Helno/pellet-grill-controller/Traeger rev 2.3.0.kicad_pro.kicad_pcb

## KiCad design Traeger rev 2.3.0.kicad_pro.kicad_pcb (2026-03-15)

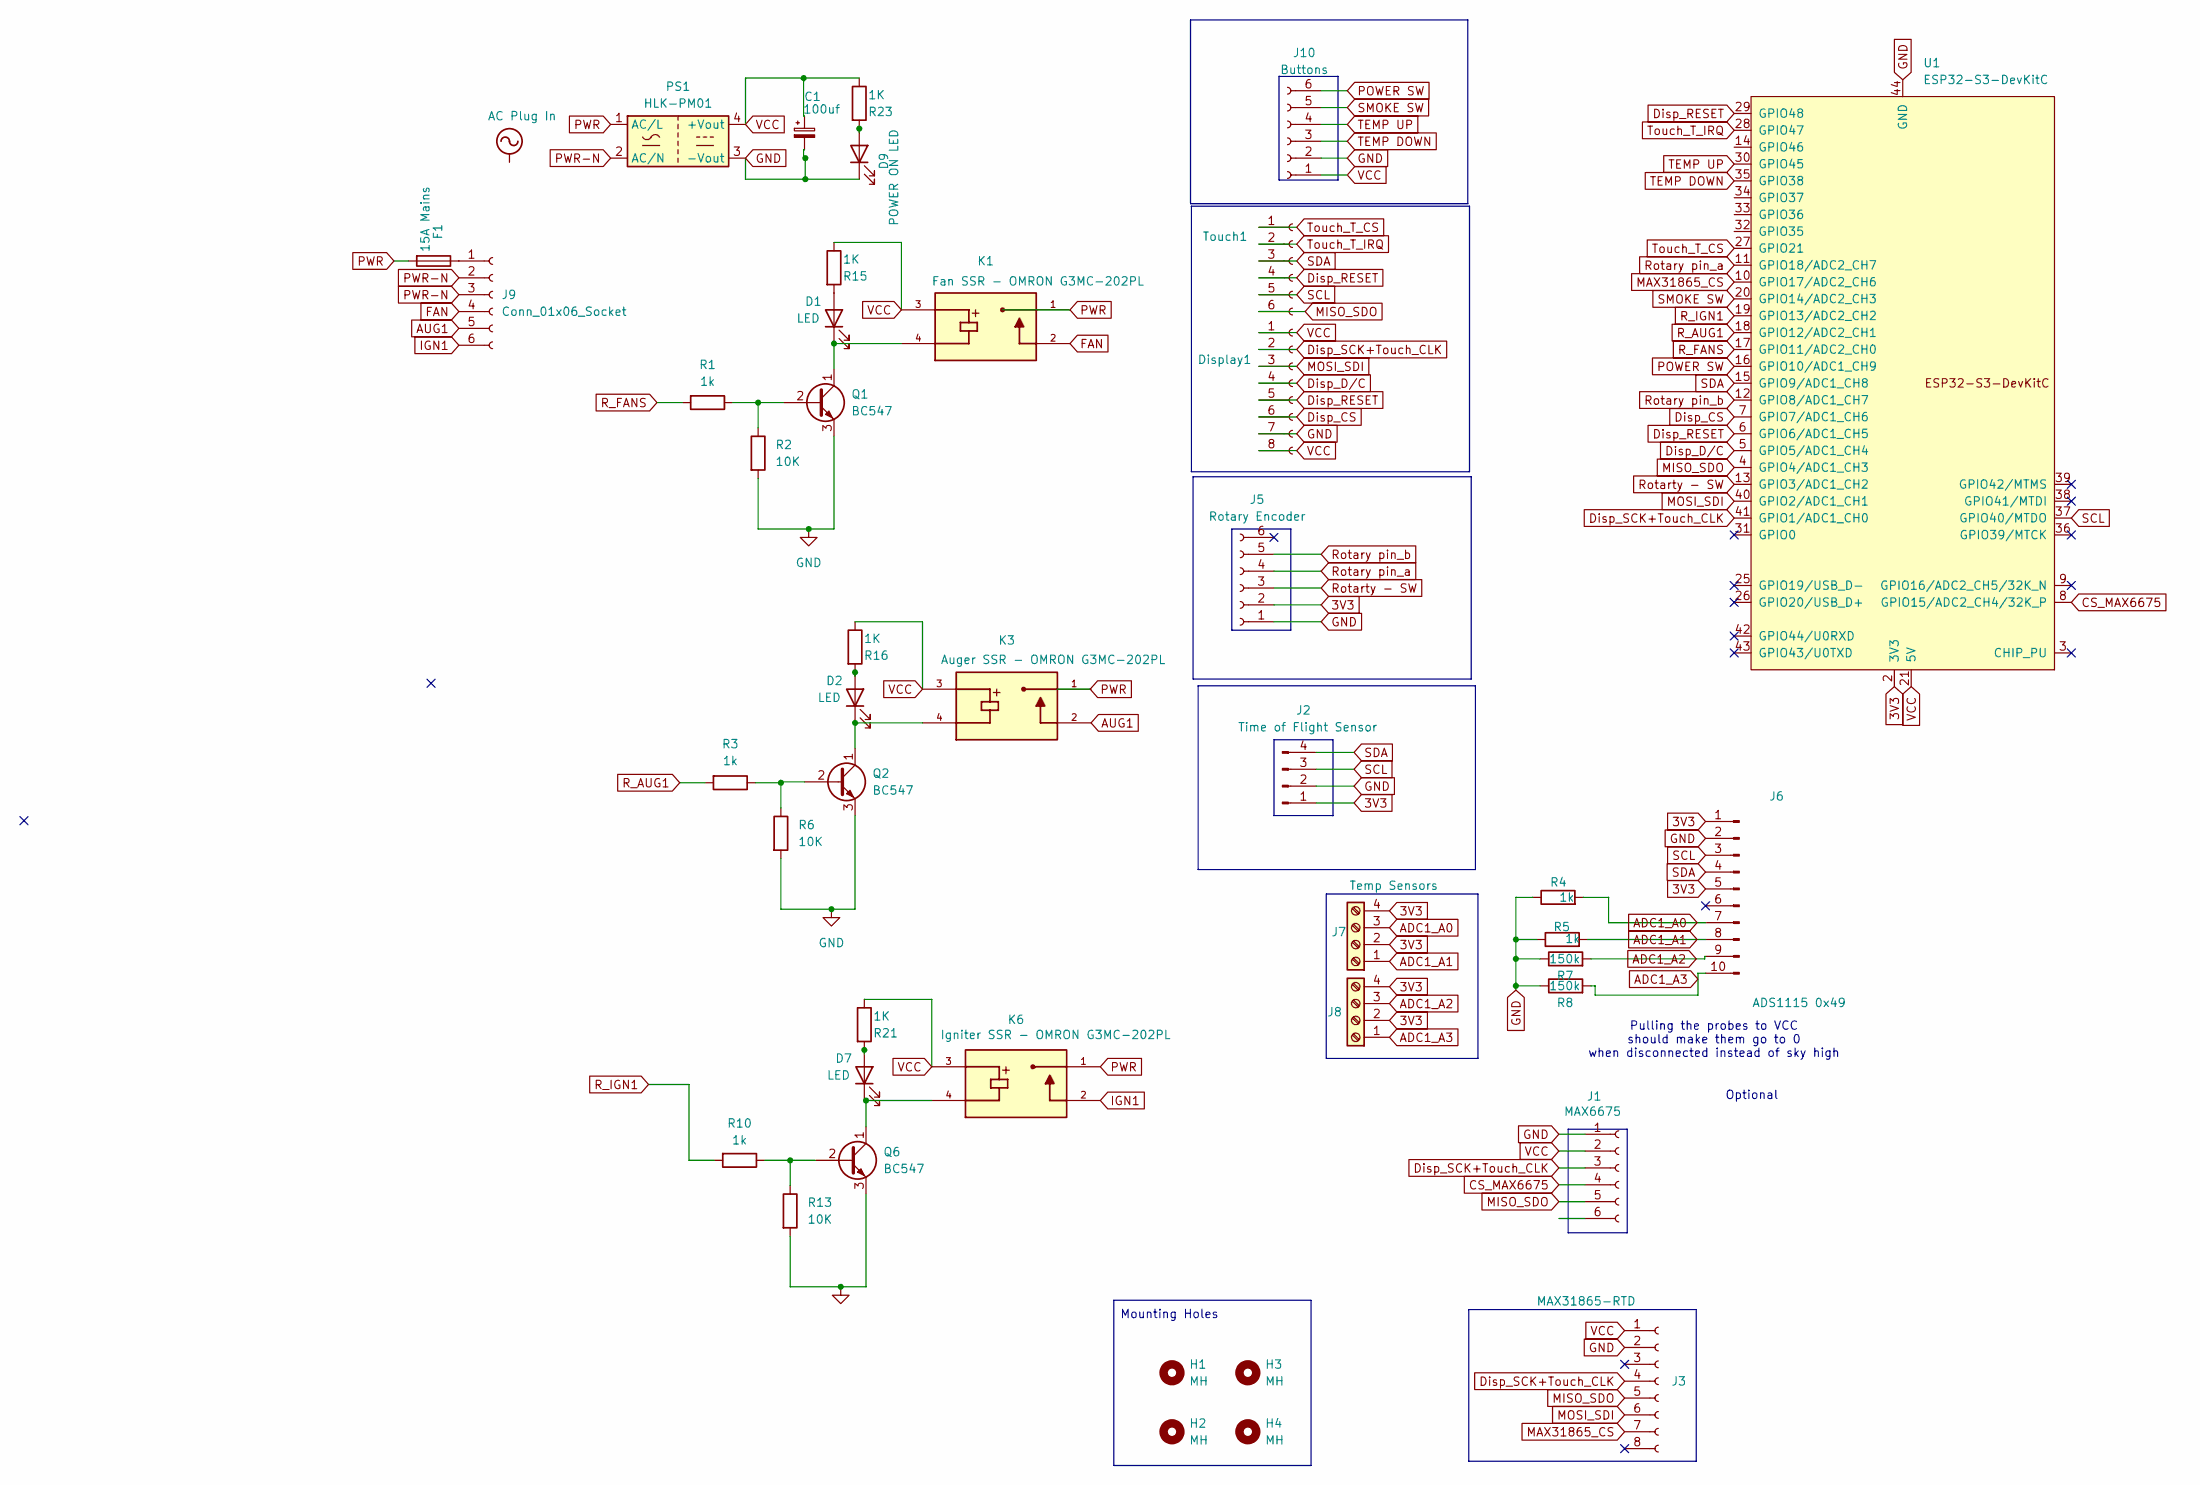
[picture p1: schematic Traeger rev 2.3.0.kicad_pro.kicad_sch, ESP32 Traeger Controller]

Parts:
C1: 100uf; CP_Radial_D8.0mm_P3.50mm
D1, D2, D7: LED; LED_D3.0mm
D9: POWER ON LED; LED_D3.0mm
Display1: Conn_01x08_Socket; JST_EH_B8B-EH-A_1x08_P2.50mm_Vertical
F1: 15A Mains; Fuse Block 3544-2_KEYSTONE
H1, H2, H3, H4: MH; MountingHole_3.2mm_M3
J1: MAX6675; JST_XH_B6B-XH-A_1x06_P2.50mm_Vertical
J2: Time of Flight Sensor; JST_EH_B4B-EH-A_1x04_P2.50mm_Vertical
J3: MAX31865-RTD; PinSocket_1x08_P2.54mm_Vertical
J5: Rotary Encoder; JST_XH_B6B-XH-A_1x06_P2.50mm_Vertical
J6: ADS1115 0x49; PinSocket_1x10_P2.54mm_Vertical
J7, J8: Temp Sensors; TerminalBlock_RND_205-00014_1x04_P5.00mm_Horizontal
J9: Conn_01x06_Socket; TerminalBlock_RND_205-00005_1x06_P5.00mm_Horizontal
J10: Buttons; JST_XH_B6B-XH-A_1x06_P2.50mm_Vertical
K1: Fan SSR - OMRON G3MC-202PL; RELAY_G3MB-202PDC5; PARTREV J091-E1-1A
K3: Auger SSR - OMRON G3MC-202PL; RELAY_G3MB-202PDC5; PARTREV J091-E1-1A
K6: Igniter SSR - OMRON G3MC-202PL; RELAY_G3MB-202PDC5; PARTREV J091-E1-1A
PS1: HLK-PM01; Converter_ACDC_Hi-Link_HLK-PMxx
Q1, Q2, Q6: BC547; TO-92L_Inline
R1, R3, R4, R5, R10: 1k; R_Axial_DIN0207_L6.3mm_D2.5mm_P7.62mm_Horizontal
R2, R6, R13: 10K; R_Axial_DIN0207_L6.3mm_D2.5mm_P7.62mm_Horizontal
R7, R8: 150k; R_Axial_DIN0207_L6.3mm_D2.5mm_P7.62mm_Horizontal
R15, R16, R21, R23: 1K; R_Axial_DIN0207_L6.3mm_D2.5mm_P7.62mm_Horizontal
Touch1: Conn_01x06_Socket; JST_EH_B6B-EH-A_1x06_P2.50mm_Vertical
U1: ESP32-S3-DevKitC

Connections:
3V3: J2.1, J5.2, J6.1, J6.5, J7.2, J7.4, J8.2, J8.4, U1.1 (3V3), U1.2 (3V3)
ADC1_A0: J6.7, J7.3, R4.2
ADC1_A1: J6.8, J7.1, R5.2
ADC1_A2: J6.9, J8.3, R7.2
ADC1_A3: J6.10, J8.1, R8.2
AUG1: J9.5, K3.2
CS_MAX6675: J1.4, U1.8 (GPIO15/ADC2_CH4/32K_P)
Disp_CS: Display1.6, U1.7 (GPIO7/ADC1_CH6)
Disp_D/C: Display1.4, U1.5 (GPIO5/ADC1_CH4)
Disp_RESET: Display1.5, Touch1.4, U1.6 (GPIO6/ADC1_CH5), U1.29 (GPIO48)
Disp_SCK+Touch_CLK: Display1.2, J1.3, J3.4, U1.41 (GPIO1/ADC1_CH0)
FAN: J9.4, K1.2
GND: C1.2, D9.1 (K), Display1.7, J1.1, J2.2, J3.2, J5.1, J6.2, J10.2, PS1.3 (-Vout), Q1.3 (E), Q2.3 (E), Q6.3 (E), R2.2, R4.1, R5.1, R6.2, R7.1, R8.1, R13.2, U1.22 (GND), U1.23 (GND), U1.24 (GND), U1.44 (GND)
IGN1: J9.6, K6.2
MAX31865_CS: J3.7, U1.10 (GPIO17/ADC2_CH6)
MISO_SDO: J1.5, J3.5, Touch1.6, U1.4 (GPIO4/ADC1_CH3)
MOSI_SDI: Display1.3, J3.6, U1.40 (GPIO2/ADC1_CH1)
unnamed: D1.2 (A), R15.2
unnamed: D1.1 (K), K1.4, Q1.1 (C)
unnamed: D2.2 (A), R16.2
unnamed: D2.1 (K), K3.4, Q2.1 (C)
unnamed: D7.2 (A), R21.2
unnamed: D7.1 (K), K6.4, Q6.1 (C)
unnamed: D9.2 (A), R23.2
unnamed: F1.1, J9.1
unnamed: Q1.2 (B), R1.1, R2.1
unnamed: Q2.2 (B), R3.1, R6.1
unnamed: Q6.2 (B), R10.1, R13.1
POWER SW: J10.6, U1.16 (GPIO10/ADC1_CH9)
PWR: F1.2, K1.1, K3.1, K6.1, PS1.1 (AC/L)
PWR-N: J9.2, J9.3, PS1.2 (AC/N)
R_AUG1: R3.2, U1.18 (GPIO12/ADC2_CH1)
R_FANS: R1.2, U1.17 (GPIO11/ADC2_CH0)
R_IGN1: R10.2, U1.19 (GPIO13/ADC2_CH2)
Rotarty - SW: J5.3, U1.13 (GPIO3/ADC1_CH2)
Rotary pin_a: J5.4, U1.11 (GPIO18/ADC2_CH7)
Rotary pin_b: J5.5, U1.12 (GPIO8/ADC1_CH7)
SCL: J2.3, J6.3, Touch1.5, U1.37 (GPIO40/MTDO)
SDA: J2.4, J6.4, Touch1.3, U1.15 (GPIO9/ADC1_CH8)
SMOKE SW: J10.5, U1.20 (GPIO14/ADC2_CH3)
TEMP DOWN: J10.3, U1.35 (GPIO38)
TEMP UP: J10.4, U1.30 (GPIO45)
Touch_T_CS: Touch1.1, U1.27 (GPIO21)
Touch_T_IRQ: Touch1.2, U1.28 (GPIO47)
VCC: C1.1, Display1.1, Display1.8, J1.2, J3.1, J10.1, K1.3, K3.3, K6.3, PS1.4 (+Vout), R15.1, R16.1, R21.1, R23.1, U1.21 (5V)

Notes on the sheet:
Pulling the probes to VCC should make them go to 0 when disconnected instead of sky high
Optional
Mounting Holes

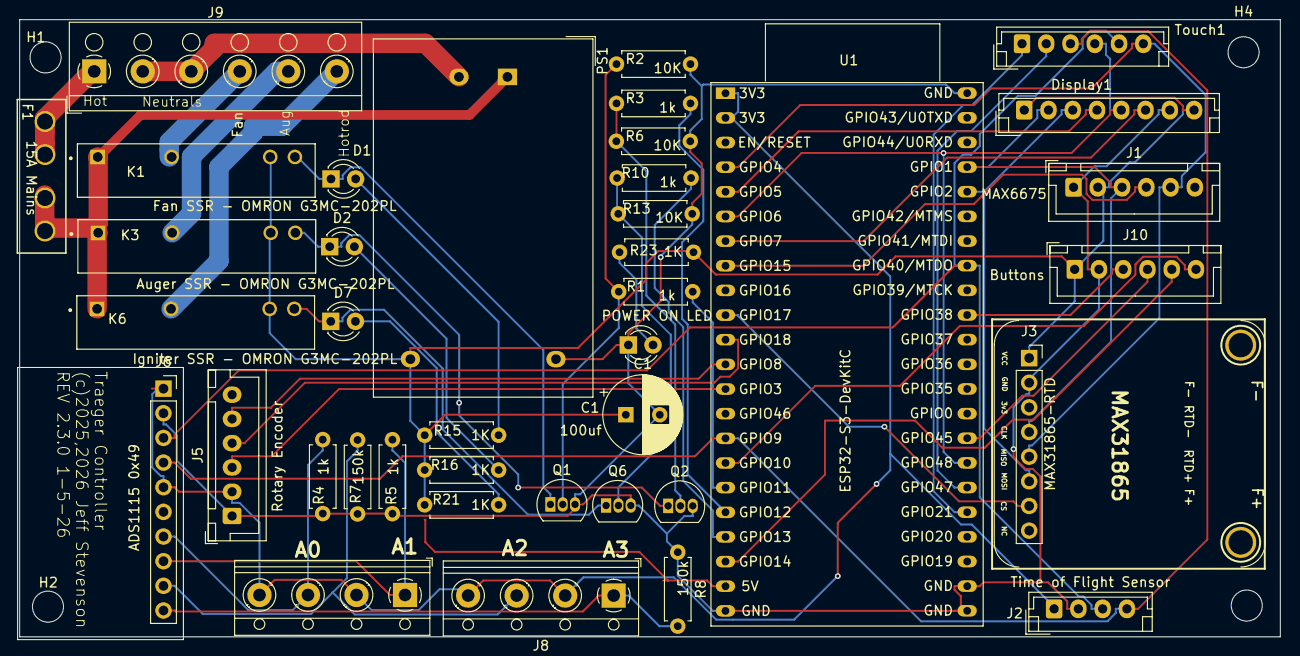
[picture p2: board Traeger rev 2.3.0.kicad_pro.kicad_pcb from above]

Board: 2 copper layers, 129.9 x 63.6 mm, 45 parts (0 on the bottom side), 45 nets.

Other parts of the board:
U$18, U$19: MOUNTINGHOLE2.5; MOUNTINGHOLE_2.5_PLATED
