Helno/pellet-grill-controller/pellet-grill-controller.yaml

# updated 8/15/25
# added flame-out relighting w/ max6675 sensor
# PID values that work really well:
# Pb=60 Ti=180 Td=45
# theta=12 tau=300 
# center= 0.0 stable win=8

esphome:
  name: "pellet-grill-controller"
  friendly_name: Pellet Grill Controller
  platformio_options:
    board_build.flash_mode: dio 
  on_boot:
    priority: -100
    then:
      - lambda: id(status_msg).publish_state("Ready");
      - delay: 3s
      - lambda: id(mydisplay).update();
      - switch.turn_on: backlight

      # Check RTD temperature and turn on fans if needed
      - if:
          condition:
            lambda: return id(rtd_temperature_f).state > 175.0;
          then:
            - switch.turn_on: fans_on_off_sw
            - lambda: id(status_msg).publish_state("Hot startup - Fans ON");
            - script.execute: sc_shutdown
          else:
            - switch.turn_off: fans_on_off_sw
            - lambda: id(status_msg).publish_state("Ready!");
      #- script.execute: sc_monitor_temp_for_fans
packages:
touchscreen:
  - platform: ft63x6
    i2c_id: i2c_bus
    interrupt_pin: GPIO47
    reset_pin: GPIO48
    id: my_touchscreen
    #update_interval: 25ms
    calibration:
      x_min: 26
      x_max: 308
      y_min: 25
      y_max: 443
    transform:
      mirror_x: true
      mirror_y: true
      swap_xy: false
    on_touch:
      - lambda: |-
            ESP_LOGI("calibration", "x=%d, y=%d, x_raw=%d, y_raw=%0d",
                touch.x,
                touch.y,
                touch.x_raw,
                touch.y_raw
                );
  
psram:
  mode: octal
  speed: 80MHz
esp32:
  board: esp32-s3-devkitc-1
  variant: esp32s3
  flash_size: 16MB
  framework:
    type: esp-idf
    version: recommended
    sdkconfig_options:
      CONFIG_ESP32_S3_BOX_BOARD: "y"
      CONFIG_ESP_WIFI_ENABLE_WPA3_SAE: "y"

api:
  reboot_timeout: 24h
logger:
    level: DEBUG
    logs:
      component: none   # screen spam updates suppressed
      api.connection: ERROR
      max31865: none
      max6675: none
      ads1115.sensor: ERROR
      sensor: ERROR 
      number: ERROR
      ili9xxx: ERROR
      FT63X6: ERROR
      spi: ERROR
      touchscreen: ERROR
      I2C: ERROR

ota:
  - platform: esphome
wifi:
  use_address: 10.59.233.56
  ssid: !secret wifi_ssid
  password: !secret wifi_password
  power_save_mode: none
  ap:
    ssid: "Pellet-Grill-Fallback"
    password: !secret wifi_password
captive_portal:

web_server:    #you can remove this if you dont want to access the web server from your network

#need to wire up touchscreen and add a CS pin to the display

spi:
  - id: spi_bus
    clk_pin: GPIO1 #display SCK/touch T_CLK
    mosi_pin: GPIO2 #SDI-max / display /touch T_DIN
    miso_pin: GPIO4 #SDO-max / touch T_DO, display doesnt need MISO

display:
  - platform: ili9xxx
    id: mydisplay
    setup_priority: -500
    spi_id: spi_bus
    data_rate: 40MHz
    model: ILI9488_A #TFT 3.5  
    dc_pin: GPIO5    
    cs_pin: GPIO7 
    reset_pin: GPIO6 #pin 5 display
    color_palette: 8BIT
    #LED - GPIO16 via jumper, controlled by backlight switch
    rotation: 90
    update_interval: 0.5s
    invert_colors: true
    show_test_card: false
    lambda: |-
       auto black = Color(0, 0, 0);
       auto red = Color(255, 0, 0);
       auto green = Color(0, 255, 0);
       auto blue = Color(0, 0, 255);
       auto white = Color(255, 255, 255);    
       auto grey = Color(120, 120, 120);

       // Temperature conversion helper: F->display unit
       auto to_disp = [](float f) -> float { return id(use_celsius) ? (f - 32.0f) * 5.0f / 9.0f : f; };
       auto unit_str = id(use_celsius) ? "C" : "F";

       //Status msg
        it.filled_rectangle(0, 452, 320, 28, Color(80, 80, 80)); // Grey background with padding
        it.print(1, 454, id(font20), id(status_msg).state.c_str());
        it.printf(306, 454, id(font20), white, TextAlign::TOP_RIGHT, "°%s", unit_str);

        it.printf(77, 1, id(font30), white, TextAlign::TOP_CENTER, "Heat");
        it.printf(243, 1, id(font30), white, TextAlign::TOP_CENTER, "Smoke");
       // Power button
       if (id(go).state && !id(smoke_mode).state) {
         // Active state - bright green with 3D effect
         it.filled_rectangle(56, 42, 42, 58, Color(0, 200, 0));  // Main button
         it.filled_rectangle(56, 40, 42, 3, Color(0, 255, 0));   // Highlight
         it.filled_rectangle(56, 100, 42, 3, Color(0, 100, 0));  // Shadow
         it.filled_rectangle(53, 42, 3, 58, Color(0, 255, 0));   // Left highlight
         it.filled_rectangle(98, 42, 3, 58, Color(0, 100, 0));   // Right shadow
       } else {
         // Inactive state - dark gray with 3D effect
         it.filled_rectangle(56, 42, 42, 58, Color(80, 80, 80)); // Main button
         it.filled_rectangle(56, 40, 42, 3, Color(120, 120, 120)); // Highlight
         it.filled_rectangle(56, 100, 42, 3, Color(40, 40, 40));   // Shadow
         it.filled_rectangle(53, 42, 3, 58, Color(120, 120, 120)); // Left highlight
         it.filled_rectangle(98, 42, 3, 58, Color(40, 40, 40));    // Right shadow
       }
       // Smoke button
       if (id(smoke_mode).state) {
         // Active state - bright blue with 3D effect
         it.filled_rectangle(222, 42, 42, 58, Color(0, 0, 200));  // Main button
         it.filled_rectangle(222, 40, 42, 3, Color(0, 0, 255));   // Highlight
         it.filled_rectangle(222, 100, 42, 3, Color(0, 0, 100));  // Shadow
         it.filled_rectangle(219, 42, 3, 58, Color(0, 0, 255));   // Left highlight
         it.filled_rectangle(264, 42, 3, 58, Color(0, 0, 100));   // Right shadow
       } else {
         // Inactive state - dark gray with 3D effect
         it.filled_rectangle(222, 42, 42, 58, Color(80, 80, 80)); // Main button
         it.filled_rectangle(222, 40, 42, 3, Color(120, 120, 120)); // Highlight
         it.filled_rectangle(222, 100, 42, 3, Color(40, 40, 40));   // Shadow
         it.filled_rectangle(219, 42, 3, 58, Color(120, 120, 120)); // Left highlight
         it.filled_rectangle(264, 42, 3, 58, Color(40, 40, 40));    // Right shadow
       }
       if (id(knob_mode) == 1) {
         it.printf(77, 118, id(font20), Color(0, 220, 0), TextAlign::TOP_CENTER, "Probe Set");
         it.printf(77, 140, id(font45), Color(0, 220, 0), TextAlign::TOP_CENTER, "%.0f°", to_disp(id(meat_probe_setpoint).state));
       } else if (id(smoke_mode).state) {
         it.printf(77, 118, id(font20), white, TextAlign::TOP_CENTER, "%s", id(p_select).current_option().c_str());
         // Slow flash: visible for ~700ms, hidden for ~300ms
         bool blink_on = (millis() % 1000) < 700;
         bool auger_on = id(auger_1_sw).state;
         auto on_color = (auger_on && blink_on) ? Color(255, 165, 0) : grey;
         auto off_color = (!auger_on && blink_on) ? white : grey;
         it.printf(37, 142, id(font30), on_color, TextAlign::TOP_CENTER, "%.0fs", id(smoke_on_time).state);
         it.printf(77, 142, id(font30), grey, TextAlign::TOP_CENTER, "/");
         it.printf(117, 142, id(font30), off_color, TextAlign::TOP_CENTER, "%.0fs", id(smoke_off_time).state);
       } else {
         it.printf(77, 118, id(font20), white, TextAlign::TOP_CENTER, "Set Temp");
         it.printf(77, 140, id(font45), white, TextAlign::TOP_CENTER, "%.0f°", to_disp(id(smoker_set_temp).state));
       }

       it.printf(243, 118, id(font20), red, TextAlign::TOP_CENTER, "RTD Temp");
       it.printf(289, 140, id(font45), red, TextAlign::TOP_RIGHT, "%.0f°", to_disp(id(rtd_temperature_f).state));

        // Temperature graph (y=200 to y=283, full width)
        {
          const int gx = 0;       // left edge
          const int gy = 200;     // top of graph
          const int gw = 320;     // width
          const int gh = 83;      // height
          const float y_min = id(use_celsius) ? 65.0f : 150.0f;
          float y_max = id(graph_y_max);
          float y_range = y_max - y_min;

          // Background
          it.filled_rectangle(gx, gy, gw, gh, Color(20, 20, 20));

          // Horizontal gridlines
          auto gridlines = id(smoke_mode).state
            ? (id(use_celsius) ? std::vector<int>{80, 95, 110} : std::vector<int>{175, 200, 225})
            : (id(use_celsius) ? std::vector<int>{100, 150, 200} : std::vector<int>{200, 300, 400});
          for (int grid_f : gridlines) {
            if (grid_f > y_min && grid_f < y_max) {
              int grid_y = gy + gh - (int)((grid_f - y_min) / y_range * gh);
              it.horizontal_line(gx, grid_y, gw, Color(50, 50, 50));
              it.printf(gx + 2, grid_y - 9, id(font_tiny), Color(100, 100, 100), "%d", grid_f);
            }
          }

          // Plot lines
          int n = id(graph_set_temp).size();
          if (n > 1) {
            for (int i = 1; i < n; i++) {
              // X positions - spread across full width
              int x1 = (i-1) * 2;
              int x2 = i * 2;

              // Set temp - white
              float sv1 = std::max(y_min, std::min(y_max, id(graph_set_temp)[i-1]));
              float sv2 = std::max(y_min, std::min(y_max, id(graph_set_temp)[i]));
              int sy1 = gy + gh - (int)((sv1 - y_min) / y_range * gh);
              int sy2 = gy + gh - (int)((sv2 - y_min) / y_range * gh);
              it.line(x1, sy1, x2, sy2, white);

              // RTD temp - red
              float rv1 = std::max(y_min, std::min(y_max, id(graph_rtd_temp)[i-1]));
              float rv2 = std::max(y_min, std::min(y_max, id(graph_rtd_temp)[i]));
              int ry1 = gy + gh - (int)((rv1 - y_min) / y_range * gh);
              int ry2 = gy + gh - (int)((rv2 - y_min) / y_range * gh);
              it.line(x1, ry1, x2, ry2, red);

              // Probe 1 - green (only when connected)
              if ((int)id(graph_probe1_temp).size() > i) {
                float p1v1 = id(graph_probe1_temp)[i-1];
                float p1v2 = id(graph_probe1_temp)[i];
                if (!isnan(p1v1) && !isnan(p1v2)) {
                  p1v1 = std::max(y_min, std::min(y_max, p1v1));
                  p1v2 = std::max(y_min, std::min(y_max, p1v2));
                  int p1y1 = gy + gh - (int)((p1v1 - y_min) / y_range * gh);
                  int p1y2 = gy + gh - (int)((p1v2 - y_min) / y_range * gh);
                  it.line(x1, p1y1, x2, p1y2, Color(0, 220, 0));
                }
              }

              // Probe 2 - yellow (only when connected)
              if ((int)id(graph_probe2_temp).size() > i) {
                float p2v1 = id(graph_probe2_temp)[i-1];
                float p2v2 = id(graph_probe2_temp)[i];
                if (!isnan(p2v1) && !isnan(p2v2)) {
                  p2v1 = std::max(y_min, std::min(y_max, p2v1));
                  p2v2 = std::max(y_min, std::min(y_max, p2v2));
                  int p2y1 = gy + gh - (int)((p2v1 - y_min) / y_range * gh);
                  int p2y2 = gy + gh - (int)((p2v2 - y_min) / y_range * gh);
                  it.line(x1, p2y1, x2, p2y2, Color(255, 200, 0));
                }
              }
            }
          }

          // Meat probe setpoint line (dashed green, only if probe connected)
          bool any_probe = id(a0_voltage).state > 0.2f || id(a1_voltage).state > 0.2f;
          if (any_probe) {
            float probe_set_disp = to_disp(id(meat_probe_setpoint).state);
            if (probe_set_disp > y_min && probe_set_disp < y_max) {
              int psy = gy + gh - (int)((probe_set_disp - y_min) / y_range * gh);
              // Dashed line
              for (int dx = gx; dx < gx + gw; dx += 6) {
                it.horizontal_line(dx, psy, 3, Color(0, 220, 0));
              }
              it.printf(gx + gw - 2, psy - 9, id(font_tiny), Color(0, 220, 0), TextAlign::TOP_RIGHT, "%.0f", probe_set_disp);
            }
          }

          // Border
          it.rectangle(gx, gy, gw, gh, Color(80, 80, 80));
        }

        // Y offset for positioning
        int y_offset = 294;

        // Draw main body of BBQ trailer
        it.rectangle(0, y_offset-8, 320, 158, blue);

        // Animation angle - used by fan and auger
        float angle = fmod(millis() / 50.0, 360.0) * M_PI / 180.0;

        // FAN - curved blade fan at cx=190
        {
          int cx = 190;
          int cy = y_offset + 24;
          int fan_r = 21;
          it.circle(cx, cy, fan_r, white); // housing circle
          if (id(fans_on_off_sw).state) {
            // 4 curved blades
            for (int i = 0; i < 4; i++) {
              float base_angle = angle + (i * M_PI / 2);
              // Each blade: arc from base to base+70deg with radius sweep
              for (int step = 0; step < 8; step++) {
                float a1 = base_angle + step * (M_PI/2 * 0.7f / 8.0f);
                float a2 = base_angle + (step+1) * (M_PI/2 * 0.7f / 8.0f);
                float r1 = fan_r * 0.2f + step * (fan_r * 0.8f / 8.0f);
                float r2 = fan_r * 0.2f + (step+1) * (fan_r * 0.8f / 8.0f);
                it.line(
                  cx + (int)(r1 * cos(a1)), cy + (int)(r1 * sin(a1)),
                  cx + (int)(r2 * cos(a2)), cy + (int)(r2 * sin(a2)),
                  green
                );
              }
            }
          } else {
            // Static - just spokes
            for (int i = 0; i < 4; i++) {
              float a = i * M_PI / 2;
              it.line(cx, cy, cx + (int)(fan_r * cos(a)), cy + (int)(fan_r * sin(a)), green);
            }
          }
          it.filled_circle(cx, cy, 4, green);
        }

        // HOTROD
        {
          int cx = 190;
          if (id(hotrod_1_sw).state) {
            it.rectangle(cx-21, y_offset + 73, 42, 68, white);
            it.filled_rectangle(cx-21, y_offset + 73, 42, 16, Color(255,0,0));
          } else {
            it.rectangle(cx-21, y_offset + 73, 42, 68, white);
          }
          // Burn pot temperature centered inside hotrod box
          it.printf(cx-16, y_offset + 101, id(font20), Color(255, 100, 0), "%.0f°",
            id(use_celsius) ? id(firepot_temperature).state : id(firepot_temperature).state * 1.8f + 32.0f);
        }

        // AUGER - horizontal side view screw feeding from hopper base to hotrod
        // Runs from x=148 to x=263, centered at y=430
        {
          const int al = 211;   // left x (hotrod right edge cx+21)
          const int ar2 = 285;  // right x (hopper base right corner)
          const int ay = y_offset + 129; // bottom edge aligned with hopper bottom
          const int aw = 10;    // half-height of screw thread
          const int shaft = 2;  // half-height of shaft
          Color auger_col = id(auger_1_sw).state ? Color(255, 165, 0) : Color(100, 100, 100);

          // Tube outline
          it.line(al, ay - aw - 2, ar2, ay - aw - 2, white);
          it.line(al, ay + aw + 2, ar2, ay + aw + 2, white);

          // Shaft (horizontal center line)
          it.filled_rectangle(al, ay - shaft, ar2 - al, shaft*2, auger_col);

          // Helix wrapping around horizontal shaft
          float phase = id(auger_1_sw).state ? fmod(millis() / 150.0f, 2.0f * M_PI) : 0.0f;
          int num_coils = 6;
          int steps = 80;

          // Back helix first (dimmer)
          for (int s = 0; s < steps; s++) {
            float t1 = (float)s / steps;
            float t2 = (float)(s+1) / steps;
            float x1f = al + t1 * (ar2 - al);
            float x2f = al + t2 * (ar2 - al);
            float a1 = phase + t1 * num_coils * 2.0f * M_PI;
            float a2 = phase + t2 * num_coils * 2.0f * M_PI;
            float by1 = ay + aw * sin(a1 + M_PI);
            float by2 = ay + aw * sin(a2 + M_PI);
            if (sin(a1) < 0) {
              it.line((int)x1f, (int)by1, (int)x2f, (int)by2, Color(80, 60, 0));
            }
          }
          // Front helix on top
          for (int s = 0; s < steps; s++) {
            float t1 = (float)s / steps;
            float t2 = (float)(s+1) / steps;
            float x1f = al + t1 * (ar2 - al);
            float x2f = al + t2 * (ar2 - al);
            float a1 = phase + t1 * num_coils * 2.0f * M_PI;
            float a2 = phase + t2 * num_coils * 2.0f * M_PI;
            float fy1 = ay + aw * sin(a1);
            float fy2 = ay + aw * sin(a2);
            if (sin(a1) >= 0) {
              it.line((int)x1f, (int)fy1, (int)x2f, (int)fy2, auger_col);
            }
          }
        }

          // Probe temps (bottom-left of BBQ body)
          it.filled_rectangle(1, 294, 128, 149, black);
          bool p1_conn = id(a0_voltage).state > 0.2f;
          bool p2_conn = id(a1_voltage).state > 0.2f;
          float probe_target = id(meat_probe_setpoint).state;
          bool probe_blink = (millis() % 800) < 500;
          if (p1_conn && p2_conn) {
            // Two probes - stacked compact layout
            bool p1_done = id(a0_temperature).state >= probe_target;
            bool p2_done = id(a1_temperature).state >= probe_target;
            auto p1_col = (p1_done && probe_blink) ? black : Color(0, 220, 0);
            auto p2_col = (p2_done && probe_blink) ? black : Color(255, 200, 0);
            it.printf(65, 304, id(font20), p1_col, TextAlign::TOP_CENTER, "P1");
            it.printf(65, 326, id(font40), p1_col, TextAlign::TOP_CENTER, "%.0f°", to_disp(id(a0_temperature).state));
            it.printf(65, 378, id(font20), p2_col, TextAlign::TOP_CENTER, "P2");
            it.printf(65, 400, id(font40), p2_col, TextAlign::TOP_CENTER, "%.0f°", to_disp(id(a1_temperature).state));
          } else if (p1_conn) {
            // Single probe - large centered
            bool p1_done = id(a0_temperature).state >= probe_target;
            auto p1_col = (p1_done && probe_blink) ? black : Color(0, 220, 0);
            it.printf(65, 330, id(font20), p1_col, TextAlign::TOP_CENTER, "P1");
            it.printf(65, 354, id(font45), p1_col, TextAlign::TOP_CENTER, "%.0f°", to_disp(id(a0_temperature).state));
          } else if (p2_conn) {
            // Single probe - large centered
            bool p2_done = id(a1_temperature).state >= probe_target;
            auto p2_col = (p2_done && probe_blink) ? black : Color(255, 200, 0);
            it.printf(65, 330, id(font20), p2_col, TextAlign::TOP_CENTER, "P2");
            it.printf(65, 354, id(font45), p2_col, TextAlign::TOP_CENTER, "%.0f°", to_disp(id(a1_temperature).state));
          }

          // Pellet hopper graphic - shifted left
          {
            const int hx = 245;     // left edge (right side)
            const int hy = 295;     // top (just inside BBQ body)
            const int hw = 60;      // full width
            const int htotal = 140; // total height
            const int hmid = hy + htotal/2;
            const int hbot = hy + htotal;
            const int hw3 = hw / 3;
            const int hbx = hx + (hw - hw3) / 2;

            float dist = id(pellet_level).state;
            if (isnan(dist) || dist < 0.047f) dist = 0.047f;
            if (dist > 0.36f) dist = 0.36f;
            float pct = 1.0f - ((dist - 0.047f) / (0.36f - 0.047f));
            int fill_pct = (int)(pct * 100);
            float fill_h = pct * (float)htotal;
            int fill_top = hbot - (int)fill_h;

            // Draw fill (red) scanline by scanline clipped to hopper shape
            for (int fy = (fill_top < hy ? hy : fill_top); fy < hbot; fy++) {
              int left_edge, right_edge;
              if (fy < hmid) {
                left_edge = hx;
                right_edge = hx + hw;
              } else {
                float t = (float)(fy - hmid) / (float)(hbot - hmid);
                left_edge  = hx  + (int)(t * (hbx - hx));
                right_edge = hx + hw - (int)(t * (hbx - hx));
              }
              it.horizontal_line(left_edge, fy, right_edge - left_edge, red);
            }

            // White outline
            it.line(hx, hy, hx, hmid, white);
            it.line(hx + hw, hy, hx + hw, hmid, white);
            it.line(hx, hmid, hbx, hbot, white);
            it.line(hx + hw, hmid, hbx + hw3, hbot, white);
            it.line(hbx, hbot, hbx + hw3, hbot, white);

            // Percentage centered in top half
            it.printf(hx + hw/2 - 18, hy + 8, id(font20), white, "%d%%", fill_pct);
          }


font:
  - file: "gfonts://Roboto"
    id: font45
    size: 45
  - file: "gfonts://Roboto"
    id: font50
    size: 50
  - file: "gfonts://Roboto"
    id: font40
    size: 40
  - file: "gfonts://Roboto"
    id: font30
    size: 30
  - file: "gfonts://Roboto"
    id: font20
    size: 20
  - file: "gfonts://Roboto"
    id: font_tiny
    size: 10



globals:
  - id: adjusting_p_select
    type: bool
    restore_value: no
    initial_value: 'true'

  - id: pot_action_global 
    type: std::string
    restore_value: yes
    initial_value: '"heating"'

  - id: p_select_index_global
    type: int
    restore_value: yes

  - id: lighting_flag_global
    type: bool
    restore_value: no
    initial_value: 'true'     

  - id: smoking_flag_global
    type: bool
    restore_value: no
    initial_value: 'false' 

  - id: page_number
    type: int
    restore_value: no
    initial_value: '1'

  - id: page_1_selected_option
    type: std::string
    restore_value: no
    initial_value: '"temp_setting"'

  - id: knob_mode
    type: int
    restore_value: no
    initial_value: '0'  # 0 = grill temp, 1 = probe setpoint

  - id: status_msg_page_1
    type: std::string
    restore_value: no
    initial_value: '""'

  - id: status_msg_page_2
    type: std::string
    restore_value: no
    initial_value: '""'

  - id: graph_set_temp
    type: std::vector<float>
    restore_value: no

  - id: graph_rtd_temp
    type: std::vector<float>
    restore_value: no

  - id: graph_y_max
    type: float
    restore_value: no
    initial_value: '450.0'

  - id: graph_probe1_temp
    type: std::vector<float>
    restore_value: no

  - id: graph_probe2_temp
    type: std::vector<float>
    restore_value: no

  - id: use_celsius
    type: bool
    restore_value: yes
    initial_value: 'false'

select:         
  - platform: template
    name: "P Select"
    id: p_select
    options:
      - "P0"
      - "P1"
      - "P2"
      - "P3"
      - "P4"
      - "P5"
      - "P6"
      - "P7"
    initial_option: "P0"
    restore_value: true
    optimistic: true
    set_action:
      - logger.log:
          format: "Chosen option: %s"
          args: ["x.c_str()"]
    on_value: #set smoke times - Pit Boss style
      - lambda: |-
          id(p_select_index_global) = i;
          switch(i) {
            case 0: id(smoke_off_time).publish_state(55);  id(smoke_on_time).publish_state(18); break;
            case 1: id(smoke_off_time).publish_state(65);  id(smoke_on_time).publish_state(18); break;
            case 2: id(smoke_off_time).publish_state(75);  id(smoke_on_time).publish_state(18); break;
            case 3: id(smoke_off_time).publish_state(85);  id(smoke_on_time).publish_state(18); break;
            case 4: id(smoke_off_time).publish_state(95);  id(smoke_on_time).publish_state(18); break;
            case 5: id(smoke_off_time).publish_state(115); id(smoke_on_time).publish_state(18); break;
            case 6: id(smoke_off_time).publish_state(130); id(smoke_on_time).publish_state(18); break;
            case 7: id(smoke_off_time).publish_state(150); id(smoke_on_time).publish_state(18); break;
          }
i2c: 
  - id:  i2c_bus
    sda: GPIO9
    scl: GPIO40
    scan: true
    #frequency: 100000
    #timeout: 100ms


ads1115:
  address: 0x49
  id: ads1115_48

sensor:  
  - platform: template
    name: "Firepot Monitor"
    id: firepot_monitor
    update_interval: 10s
    lambda: |-
      if (id(go).state) {
        if (!id(smoke_mode).state) {
          // Heating mode: 300F = 148.9C, 325F = 162.8C
          if (id(firepot_temperature).state < 148.9) {
            if (!id(hotrod_1_sw).state) {
              id(hotrod_1_sw).turn_on();
            }
            ESP_LOGD("Firepot", "Heating mode: Turning on hotrod - firepot temperature below 300F");
            return 1.0;
          } else if (id(firepot_temperature).state > 162.8) {
            if (id(hotrod_1_sw).state) {
              id(hotrod_1_sw).turn_off();
              ESP_LOGD("Firepot", "Heating mode: Turning off hotrod - firepot temperature above 325F");
            }
            return 0.0;
          }
        } else {
          // Smoke mode: 160F = 71.1C, 200F = 93.3C
          if (id(firepot_temperature).state < 71.1) {
            if (!id(hotrod_1_sw).state) {
              id(hotrod_1_sw).turn_on();
            }
            ESP_LOGD("Firepot", "SMOKE MODE:Turning on hotrod - firepot temperature below 160F");
            return 1.0;         
          } else if (id(firepot_temperature).state > 93.3) {
            if (id(hotrod_1_sw).state) {
              id(hotrod_1_sw).turn_off();
              ESP_LOGD("Firepot", "SMOKE MODE:Turning off hotrod - firepot temperature above 200F");
            }
            return 0.0;
          }
        }
      }
      return 0.0;
  - platform: max6675
    name: "FirePot Temperature"
    id: firepot_temperature
    cs_pin: GPIO15
    update_interval: 5s

  - platform: max31865
    #name: "RTD Temperature raw"
    id: rtd_temperature_c
    cs_pin: GPIO17 
    spi_id: spi_bus 
    reference_resistance: "4280 Ω"
    rtd_nominal_resistance: "1000 Ω"
    data_rate: 4MHz
    update_interval: 1s
    rtd_wires: 2
    filters:
      - filter_out: NaN

  - platform: template
    name: "RTD Temperature"
    id: rtd_temperature_f
    unit_of_measurement: "°F"
    accuracy_decimals: 1
    update_interval: 1s
    lambda: |-
      if (id(rtd_temperature_c).has_state()) {
        return id(rtd_temperature_c).state * 1.8 + 32.0;
      } else {
        return 0.0;
      }   
    filters:
      - offset: +10

  - platform: vl53l0x  
    name: "Pellet Level"
    id: pellet_level
    long_range: true
    timeout: 200us
    update_interval: 5s
    unit_of_measurement: "m"
    accuracy_decimals: 2
    filters:
      - filter_out: nan
      - clamp:
          min_value: 0.047
          max_value: 0.36


      
############## ADC1_A0 ##############
  - platform: template
    name: "A0 Thermistor Resistance"
    unit_of_measurement: "Ω"
    update_interval: never
    id: a0_thermistor_resistance

  - platform: template
    name: "A0 Temperature"
    id: a0_temperature
    unit_of_measurement: "°F"
    accuracy_decimals: 2
    update_interval: never

  - platform: ads1115
    multiplexer: 'A0_GND'
    name: "A0 ADS1115 to GND"
    ads1115_id: ads1115_48
    id: a0_voltage
    unit_of_measurement: "V"
    accuracy_decimals: 4
    update_interval: 5s
    gain: 6.144
    filters:
      median:
        window_size: 7
        send_every: 1
    on_value:
      then:
        - lambda: |-
            // Calculate thermistor resistance
            const float Vcc = 3.31;       // Supply voltage (measured)
            const float R_1 = 1000;    // Fixed resistor (1kΩ)
            float Vout = id(a0_voltage).state;
            float R_thermistor = 0;

            if (Vout > 0) {
              R_thermistor = R_1 * (Vcc - Vout) / Vout;
            }

            // Linear calibration from ice bath / boiling water measurements
            float temperature = 0;
            if (R_thermistor > 0) {
              const float R_at_0C  = 1017.3;
              const float slope    = 3.779;  // Ω/°C
              float T_celsius = (R_thermistor - R_at_0C) / slope;
              temperature = (T_celsius * 9.0 / 5.0) + 32.0;
            }

            // Publish values to the sensors
            id(a0_thermistor_resistance).publish_state(R_thermistor);
            id(a0_temperature).publish_state(temperature);

############## ADC1_A1 ##############
  - platform: template
    name: "A1 Thermistor Resistance"
    unit_of_measurement: "Ω"
    update_interval: never
    id: a1_thermistor_resistance

  - platform: template
    name: "A1 Temperature"
    id: a1_temperature  
    unit_of_measurement: "°F"
    accuracy_decimals: 2
    update_interval: never

  - platform: ads1115
    multiplexer: 'A1_GND'
    name: "A1 ADS1115 to GND"
    ads1115_id: ads1115_48
    id: a1_voltage
    unit_of_measurement: "V"
    accuracy_decimals: 4
    update_interval: 5s
    gain: 6.144  # measures up to 6.144v
    filters:
      median: 
        window_size: 7
        send_every: 1
    on_value:
      then:
        - lambda: |-
            // Calculate thermistor resistance
            const float Vcc = 3.31;       // Supply voltage (measured)
            const float R_1 = 1000;    // Fixed resistor (1kΩ)
            float Vout = id(a1_voltage).state;
            float R_thermistor = 0;
            
            if (Vout > 0) {  // Avoid division by zero
              R_thermistor = R_1 * (Vcc - Vout) / Vout;
              //(148600 * (4.971-2.595)) / 2.595 
            }
            
            // Linear calibration from ice bath / boiling water measurements
            float temperature = 0;
            if (R_thermistor > 0) {
              const float R_at_0C  = 1005.6;
              const float slope    = 3.760;  // Ω/°C
              float T_celsius = (R_thermistor - R_at_0C) / slope;
              temperature = (T_celsius * 9.0 / 5.0) + 32.0;
            }

            // Publish values to the sensors
            id(a1_thermistor_resistance).publish_state(R_thermistor);
            id(a1_temperature).publish_state(temperature);


# ############## ADC1_A2 (disabled - 150kΩ resistor not replaced) ##############
#   - platform: template
#     name: "A2 Thermistor Resistance"
#     unit_of_measurement: "Ω"
#     update_interval: never
#     id: a2_thermistor_resistance
#
#   - platform: template
#     name: "A2 Temperature"
#     id: a2_temperature
#     unit_of_measurement: "°F"
#     accuracy_decimals: 2
#     update_interval: never
#
#   - platform: ads1115
#     multiplexer: 'A2_GND'
#     name: "A2 ADS1115 to GND"
#     ads1115_id: ads1115_48
#     id: a2_voltage
#     update_interval: 5s
#     gain: 6.144

# ############## ADC1_A3 (disabled - 150kΩ resistor not replaced) ##############
#   - platform: template
#     name: "A3 Thermistor Resistance"
#     unit_of_measurement: "Ω"
#     update_interval: never
#     id: a3_thermistor_resistance
#
#   - platform: template
#     name: "A3 Temperature"
#     id: a3_temperature
#     unit_of_measurement: "°F"
#     accuracy_decimals: 2
#     update_interval: never
#
#   - platform: ads1115
#     multiplexer: 'A3_GND'
#     name: "A3 ADS1115 to GND"
#     id: a3_voltage
#     ads1115_id: ads1115_48
#     update_interval: 5s
#     gain: 6.144

  - platform: rotary_encoder
    name: "Rotary Encoder"
    pin_a: 
      number: GPIO18 
      inverted: true
    pin_b: 
      number: GPIO8 
      inverted: false
    id: rotary
    on_clockwise:
        - lambda: |-
            if (id(knob_mode) == 1) {
              // Adjust meat probe setpoint
              float new_temp = id(meat_probe_setpoint).state + 5;
              if (new_temp <= id(meat_probe_setpoint).traits.get_max_value()) {
                id(meat_probe_setpoint).publish_state(new_temp);
              }
            } else if (!id(smoke_mode).state) {
              float current_temp = id(smoker_set_temp).state;
              float increment = (current_temp <= 225) ? 5 : 25;
              float new_temp = current_temp + increment;
              new_temp = (current_temp <= 225) ? round(new_temp / 5) * 5 : round(new_temp / 25) * 25;
              if (new_temp <= id(smoker_set_temp).traits.get_max_value()) {
                id(smoker_set_temp).publish_state(new_temp);
              }
            } else {
              // Adjust p_select
              auto current_index = id(p_select).index_of(id(p_select).state);
              if (current_index.has_value()) {
                int next_index = (current_index.value() + 1) % 8;
                id(p_select).make_call().set_index(next_index).perform();
              }
            }

    on_anticlockwise:
        - lambda: |-
            if (id(knob_mode) == 1) {
              // Adjust meat probe setpoint
              float new_temp = id(meat_probe_setpoint).state - 5;
              if (new_temp >= id(meat_probe_setpoint).traits.get_min_value()) {
                id(meat_probe_setpoint).publish_state(new_temp);
              }
            } else if (!id(smoke_mode).state) {
              float current_temp = id(smoker_set_temp).state;
              float increment = (current_temp <= 225) ? -5 : -25;
              float new_temp = current_temp + increment;
              new_temp = (current_temp <= 225) ? round(new_temp / 5) * 5 : round(new_temp / 25) * 25;
              if (new_temp >= 140 && new_temp <= id(smoker_set_temp).traits.get_max_value()) {
                id(smoker_set_temp).publish_state(new_temp);
              }
            } else {
              // Adjust p_select
              auto current_index = id(p_select).index_of(id(p_select).state);
              if (current_index.has_value()) {
                int next_index = (current_index.value() - 1) % 8;
                id(p_select).make_call().set_index(next_index).perform();
              }
            }

button:
  - platform: restart #allows remote reset of tywe1s chip from home assistant or internally
    id: restart_esp
    name: "Controller Restart" 
  - platform: factory_reset
    name: Restart with Factory Default Settings    
  - platform: template
    name: "Emergency Stop"
    id: sc_stop_all_smoking_button
    on_press:
      - script.execute: sc_stop_all_smoking

text_sensor:
  - platform: template
    id: status_msg
    name: "Status Message"

  - platform: template
    id: status_msg_saved_page_1

switch:

  - platform: gpio
    pin: GPIO16
    id: backlight
    name: "Display Backlight"
    restore_mode: ALWAYS_OFF

  - platform: template
    optimistic: true
    name: "System ON/OFF"
    id: go
    restore_mode: ALWAYS_OFF
    on_turn_on:
      - logger.log: "System turned ON"
      - globals.set:
          id: lighting_flag_global
          value: 'true'
      - script.execute: sc_pid_control
      - logger.log: "turning ON fan"
      - switch.turn_on: fans_on_off_sw
      - if:
          condition:
            lambda: |-
              float fp = id(firepot_temperature).state;
              float rtd = id(rtd_temperature_f).state;
              // Hot if firepot > 175F (79.4C), OR if RTD > 175F (sensor may not have reported yet)
              return (fp > 79.4) || (rtd > 175.0);
          then:
            - logger.log: "Hot start detected - skipping ignition"
            - lambda: id(status_msg).publish_state("Hot Start - Resuming");
            - globals.set:
                id: lighting_flag_global
                value: 'false'
            - script.execute: sc_pot_heating
          else:
            - script.execute: sc_light_pot
     
    on_turn_off:
      - logger.log: "System turned OFF"
      - switch.turn_off: smoke_mode    
      - switch.turn_off: hotrod_1_sw
      - switch.turn_off: auger_1_sw        
      - script.execute: sc_stop_all_smoking
      - lambda: id(status_msg).publish_state("Turned OFF"); 
      - script.execute: sc_shutdown
#
  - platform: template
    optimistic: true
    name: "Smoking Mode ON/OFF"
    id: smoke_mode
    on_turn_on:
      - if:
          condition:
            - switch.is_on: go
          then:
            - switch.turn_off: hotrod_1_sw
            - script.stop:  sc_light_pot  #turn off lighting
            - logger.log: "Smoke Mode turned ON"
            - lambda: id(status_msg).publish_state("Smoking Mode"); 
            - script.stop: sc_pot_heating          
            - script.execute: sc_pot_smoking
            - switch.turn_on: fans_on_off_sw
    on_turn_off:
      - if:
          condition:
            - switch.is_on: go
          then:
            - logger.log: "sw.Heating Mode"
            - lambda: id(status_msg).publish_state("Heating Mode");
            - script.stop: sc_pot_smoking
            - script.execute: sc_pot_heating
#
  - platform: template
    name: "Temperature Units °C"
    id: temp_units_celsius
    optimistic: true
    restore_mode: RESTORE_DEFAULT_OFF
    icon: mdi:temperature-celsius
    on_turn_on:
      - globals.set:
          id: use_celsius
          value: 'true'
      - lambda: id(mydisplay).update();
    on_turn_off:
      - globals.set:
          id: use_celsius
          value: 'false'
      - lambda: id(mydisplay).update();

  - platform: gpio
    pin: GPIO11
    name: "-Fans On/Off"
    inverted: no
    id: fans_on_off_sw
    on_turn_on:
      - lambda: |-
            ESP_LOGD("Fans ON: RTD Probe", "RTD Temp: %.3f", id(rtd_temperature_f).state);        
    on_turn_off:
      - lambda: |-
            ESP_LOGD("Fans OFF: RTD Probe", "RTD Temp: %.3f", id(rtd_temperature_f).state);

  - platform: gpio
    pin: GPIO12
    name: "-Auger 1 SW"
    inverted: no
    id: auger_1_sw
    restore_mode: ALWAYS_OFF

  - platform: gpio
    pin: GPIO13
    name: "-HotRod 1 SW"
    inverted: no
    id: hotrod_1_sw
    restore_mode: ALWAYS_OFF

binary_sensor:

  - platform: gpio
    pin:
      number: GPIO10
      mode:
        input: true
        pullup: true
    name: "Power Button"
    filters:
      - invert:
      - delayed_on: 10ms
    on_press:
      - switch.toggle: go
      - logger.log: "Power button pressed - toggling system"
      - lambda: id(mydisplay).update();

  - platform: gpio
    pin:
      number: GPIO14
      mode:
        input: true
        pullup: true
    name: "Smoke Mode Button"
    filters:
      - invert:
      - delayed_on: 10ms
    on_press:
      - switch.toggle: smoke_mode
      - logger.log: "Smoke mode button pressed - toggling smoke mode"
      - lambda: id(mydisplay).update();


  - platform: gpio
    pin:
      number: GPIO38
      mode:
        input: true
        pullup: true
    name: "Temperature Down"
    filters:
      - invert:
      - delayed_on: 10ms
    on_press:
      - lambda: |-
          if (id(knob_mode) == 1) {
            float new_temp = id(meat_probe_setpoint).state - 5;
            if (new_temp >= id(meat_probe_setpoint).traits.get_min_value()) {
              id(meat_probe_setpoint).publish_state(new_temp);
              id(mydisplay).update();
            }
          } else if (!id(smoke_mode).state) {
            float current_temp = id(smoker_set_temp).state;
            float increment = (current_temp <= 225) ? -5 : -25;
            float new_temp = current_temp + increment;
            new_temp = (current_temp <= 225) ? round(new_temp / 5) * 5 : round(new_temp / 25) * 25;
            if (new_temp >= 140 && new_temp <= id(smoker_set_temp).traits.get_max_value()) {
              id(smoker_set_temp).state = new_temp;
              id(mydisplay).update();
              id(smoker_set_temp).publish_state(new_temp);
            }
          } else {
            // Adjust p_select
            auto current_index = id(p_select).index_of(id(p_select).state);
            if (current_index.has_value()) {
              int next_index = (current_index.value() - 1) % 8;
              if (next_index < 0) next_index += 8;
              id(p_select).make_call().set_index(next_index).perform();
              id(mydisplay).update();
            }
          }

  - platform: gpio
    pin:
      number: GPIO45
      mode:
        input: true
        pullup: true
    name: "Temperature Up"
    filters:
      - invert:
      - delayed_on: 10ms
    on_press:
      - lambda: |-
          if (id(knob_mode) == 1) {
            float new_temp = id(meat_probe_setpoint).state + 5;
            if (new_temp <= id(meat_probe_setpoint).traits.get_max_value()) {
              id(meat_probe_setpoint).publish_state(new_temp);
              id(mydisplay).update();
            }
          } else if (!id(smoke_mode).state) {
            float current_temp = id(smoker_set_temp).state;
            float increment = (current_temp <= 225) ? 5 : 25;
            float new_temp = current_temp + increment;
            new_temp = (current_temp <= 225) ? round(new_temp / 5) * 5 : round(new_temp / 25) * 25;
            if (new_temp >= 140 && new_temp <= id(smoker_set_temp).traits.get_max_value()) {
              id(smoker_set_temp).state = new_temp;
              id(mydisplay).update();
              id(smoker_set_temp).publish_state(new_temp);
            }
          } else {
            // Adjust p_select
            auto current_index = id(p_select).index_of(id(p_select).state);
            if (current_index.has_value()) {
              int next_index = (current_index.value() + 1) % 8;
              id(p_select).make_call().set_index(next_index).perform();
              id(mydisplay).update();
            }
          }

  - platform: touchscreen
    id: touch_key_POWER
    x_min: 40
    x_max: 115
    y_min: 35
    y_max: 110
    on_press:
      - logger.log: "POWER was touched"
      - switch.toggle: go
      - lambda: id(mydisplay).update();
  - platform: touchscreen
    id: touch_key_SMOKE
    x_min: 205
    x_max: 280
    y_min: 35
    y_max: 110
    on_press:
      - logger.log: "SMOKE was touched"
      - switch.toggle: smoke_mode
      - lambda: id(mydisplay).update();

  - platform: touchscreen
    id: touch_key_UNITS
    x_min: 260
    x_max: 320
    y_min: 452
    y_max: 480
    on_press:
      - switch.toggle: temp_units_celsius
      - lambda: id(mydisplay).update();

  - platform: touchscreen
    id: touch_key_HOTROD_1
    x_min: 169
    x_max: 211
    y_min: 367
    y_max: 435
    on_press:
      - logger.log: "HotRod was touched"
      - switch.toggle: hotrod_1_sw
      - lambda: id(mydisplay).update();

  - platform: gpio
    pin: 
      number: GPIO3
      mode:
        input: true
        pullup: true
    name: "Rotary Switch"
    id: rotary_switch
    filters:
      invert: 
    on_multi_click:
      - timing:
        - ON for at most 1s
        - OFF for at least 0.5s
        then:
          - logger.log: "Single Click - Toggling adjustment selection"
          - lambda: |-
               bool probe_connected = id(a0_voltage).state > 0.2f || id(a1_voltage).state > 0.2f;
               if (id(knob_mode) == 0 && probe_connected) {
                 id(knob_mode) = 1;
                 id(status_msg).publish_state("Adjusting Probe Setpoint");
               } else {
                 id(knob_mode) = 0;
                 if (id(smoke_mode).state) {
                   id(status_msg).publish_state("Adjusting P Level");
                 } else {
                   id(status_msg).publish_state("Adjusting Temp");
                 }
               }
               id(mydisplay).update();        

      - timing:
          - ON for at least 1s
        then:
          - logger.log: "Rotary Switch Long Pressed Toggling Display Page"
          - lambda: |-
              if (id(page_number) == 1) {
                id(status_msg_saved_page_1).publish_state(id(status_msg).state);
                id(page_number) = 2;
                id(status_msg).publish_state("  ");
              } else {
                id(page_number) = 1;
                id(status_msg).publish_state(id(status_msg_saved_page_1).state);
              }          
      - timing:
        - ON for at most 1s
        - OFF for at most 1s
        - ON for at most 1s
        - OFF for at least 0.2s
        then:
          - logger.log: "Double Click Detected"

  # - platform: gpio
  #   pin: 
  #     number: GPIO11
  #     mode:
  #       input: true
  #   name: "Power On Button"
  #   id: btn_on
  #   filters:
  #     - invert:
  #     - delayed_on_off: 50ms
  #   on_multi_click:
  #     - timing:
  #         - ON for at least .75s
  #       then:
  #         - script.stop: sc_monitor_temp_for_fans
  #         - script.execute: sc_monitor_temp_for_fans
  #         - logger.log: "Long press detected"      
  #         - switch.toggle: go
          
  # - platform: gpio
  #   pin: 
  #     number: GPIO12
  #     mode:
  #       input: true
  #   name: "Smoke On/Off Button" 
  #   id: btn_off
  #   filters:
  #     - invert:
  #     - delayed_on_off: 10ms
  #   on_press:
  #     - lambda: |-
  #         if (id(go).state) {
  #           if (id(smoke_mode).state) {
  #             id(smoke_mode).turn_off();
  #           } else {
  #             id(smoke_mode).turn_on();
  #           }
  #         } else {
  #           if (id(smoke_mode).state) {
  #             id(smoke_mode).turn_off();
  #           } else {
  #             id(smoke_mode).turn_on(); 
  #           }
  #         }
  #     - logger.log: "Smoke On/Off Button Pressed"

  # - platform: gpio
  #   pin: 
  #     number: GPIO13
  #     mode:
  #       input: true
  #   name: "Temperature Up Button"
  #   id: btn_temp_up
  #   filters:
  #     - invert:
  #     - delayed_on_off: 20ms
  #   on_press:
  #     then:
  #       - lambda: |-
  #           float new_temp = id(smoker_set_temp).state + 5;
  #           if (new_temp <= id(smoker_set_temp).traits.get_max_value()) {
  #             id(smoker_set_temp).publish_state(new_temp);
  #           }
  #       - logger.log: "Temperature Up Button Pressed"
  #   on_multi_click:
  #   - timing:
  #       - ON for at least 0.75s
  #     then:
  #       - logger.log: "Long press detected"
  #       - while:
  #           condition:
  #             binary_sensor.is_on: btn_temp_up
  #           then:
  #             - lambda: |-
  #                 float new_temp = id(smoker_set_temp).state + 5;
  #                 if (new_temp <= id(smoker_set_temp).traits.get_max_value()) {
  #                   id(smoker_set_temp).publish_state(new_temp);
  #                 }
  #             - delay: 100ms

  # - platform: gpio
  #   pin: 
  #     number: GPIO20
  #     mode:
  #       input: true
  #   name: "Temperature Down Button"
  #   id: btn_temp_down
  #   filters:
  #     - invert:
  #     - delayed_on_off: 20ms
  #   on_press:
  #     then:
  #       - lambda: |-
  #           float new_temp = id(smoker_set_temp).state - 5;
  #           if (new_temp >= id(smoker_set_temp).traits.get_min_value()) {
  #             id(smoker_set_temp).publish_state(new_temp);
  #           }
  #       - logger.log: "Temperature Down Button Pressed"
  #   on_multi_click:
  #   - timing:
  #       - ON for at least 0.75s
  #     then:
  #       - logger.log: "Long press detected"
  #       - while:
  #           condition:
  #             binary_sensor.is_on: btn_temp_down
  #           then:
  #             - lambda: |-
  #                 float new_temp = id(smoker_set_temp).state - 5;
  #                 if (new_temp >= id(smoker_set_temp).traits.get_min_value()) {
  #                   id(smoker_set_temp).publish_state(new_temp);
  #                 }
  #             - delay: 100ms

  # - platform: template
  #   id: smoke_flag
  #   name: "Smoking Flag"
  #   lambda: |-
  #       if (id(smoking_flag_global) == 1) {
  #         return true;
  #       } else {
  #         return false;
  #       }    
  - platform: template
    id: lighting_flag
    name: "Lighting Flag"
    lambda: |-
        if (id(lighting_flag_global) == 1) {
          return true;
        } else {
          return false;
        }

number:
#PID values
  - platform: template
    name: "PID Proportional Band"
    id: pid_pb
    optimistic: true
    min_value: 10
    max_value: 200
    step: 1
    restore_value: true
    initial_value: 60.0
    mode: box
    icon: mdi:tune-vertical
    
  - platform: template
    name: "PID Ti (Reset Time)"
    id: pid_ti
    optimistic: true
    min_value: 0
    max_value: 600
    step: 1
    restore_value: true
    initial_value: 180.0
    mode: box
    icon: mdi:timer-sync
    
  - platform: template
    name: "PID Td (Rate Time)"
    id: pid_td
    optimistic: true
    min_value: 0
    max_value: 120
    step: 1    
    restore_value: true
    initial_value: 45.0
    mode: box
    icon: mdi:timer-outline

  - platform: template
    name: "PID Tau"
    id: pid_tau
    min_value: 0
    max_value: 600
    step: 1
    initial_value: 115
    optimistic: true
    restore_value: true
    unit_of_measurement: "s"

  - platform: template
    name: "PID Theta"
    id: pid_theta
    min_value: 0
    max_value: 120
    step: 1
    initial_value: 65
    optimistic: true
    restore_value: true
    unit_of_measurement: "s"
    mode: box
    icon: mdi:tune-vertical

  - platform: template
    name: "PID Center Factor"
    id: pid_center_factor
    min_value: 0.0
    max_value: 1.0
    step: 0.0001
    initial_value: 0.001
    optimistic: true
    restore_value: true
    mode: box
    icon: mdi:tune-vertical

  - platform: template
    name: "PID Stable Window"
    id: pid_stable_window
    min_value: 0
    max_value: 50
    step: 1
    initial_value: 25
    optimistic: true
    restore_value: true
    unit_of_measurement: "°F"
    mode: box
    icon: mdi:tune-vertical    

  - platform: template
    name: "Meat Probe Setpoint"
    id: meat_probe_setpoint
    min_value: 100
    max_value: 212
    step: 5
    initial_value: 165
    optimistic: true
    restore_value: true
    unit_of_measurement: "°F"
    mode: slider
    icon: mdi:thermometer-alert

  - platform: template
    name: "Smoke Auger On Time (10s)"
    id: smoke_on_time
    restore_value: yes
    min_value: 5
    max_value: 20
    step: 1
    initial_value: 10
    optimistic: true
    unit_of_measurement: "s"
    mode: box

  - platform: template
    name: "Smoke Auger Off Time (P val)"
    id: smoke_off_time
    restore_value: yes
    min_value: 5
    max_value: 20
    step: 1
    initial_value: 30
    optimistic: true
    unit_of_measurement: "s"
    mode: box

  - platform: template
    name:  "PID Error Temp"
    id: pid_error
    min_value: 0
    max_value: 600
    step: 1
    initial_value: 100
    optimistic: true
    restore_value: false
    unit_of_measurement: "°F"

  - platform: template
    name: Smoker Set Temperature
    id: smoker_set_temp
    min_value: 140
    max_value: 550
    step: 5
    initial_value: 325
    optimistic: true
    restore_value: false
    update_interval: 60s
    unit_of_measurement: "°F"
    mode: slider
    on_value:
      - script.execute: sc_pid_control    

#Pot lighting times
  - platform: template
    name: Pot lighting ON Time
    id: pot_lighting_on_time
    min_value: 1
    max_value: 120
    step: 1
    initial_value: 60
    optimistic: true
    restore_value: false
    unit_of_measurement: "s"
    mode: slider
    icon: mdi:timer-settings

  - platform: template
    name: Pot lighting OFF Time
    id: pot_lighting_off_time
    min_value: 1
    max_value: 360
    step: 1
    initial_value: 600
    optimistic: true
    restore_value: false
    unit_of_measurement: "s"
    mode: slider
    icon: mdi:timer-settings

# Heating times
  - platform: template
    name: Augers Heating ON Time
    id: augers_heating_on_time
    min_value: 3
    max_value: 20
    step: 0.5
    initial_value: 15
    optimistic: true
    restore_value: true
    unit_of_measurement: "s"
    mode: slider
    icon: mdi:timer-settings    

  - platform: template
    name: Augers Heating OFF Time
    id: augers_heating_off_time    
    min_value: 0
    max_value: 20
    step: 0.5
    initial_value: 1
    optimistic: true
    restore_value: true
    unit_of_measurement: "s"
    mode: slider
    icon: mdi:timer-settings-outline

  - platform: template
    name: "Smoke Cycle Delay"
    id: smoke_cycle_delay
    min_value: 30
    max_value: 90
    step: 5
    initial_value: 45
    optimistic: true
    restore_value: true
    unit_of_measurement: "s"
    mode: slider
    icon: mdi:timer-sync


interval:
  - interval: 30s
    then:
      - lambda: |-
          const int MAX_POINTS = 160; // 80 minutes at 30s intervals, 2px per point
          auto to_disp = [](float f) -> float { return id(use_celsius) ? (f - 32.0f) * 5.0f / 9.0f : f; };
          float set_t = to_disp(id(smoker_set_temp).state);
          float rtd_t = to_disp(id(rtd_temperature_f).state);
          float p1_t = id(a0_voltage).state > 0.2f ? to_disp(id(a0_temperature).state) : NAN;
          float p2_t = id(a1_voltage).state > 0.2f ? to_disp(id(a1_temperature).state) : NAN;
          id(graph_set_temp).push_back(set_t);
          id(graph_rtd_temp).push_back(rtd_t);
          id(graph_probe1_temp).push_back(p1_t);
          id(graph_probe2_temp).push_back(p2_t);
          if (id(graph_set_temp).size() > MAX_POINTS) {
            id(graph_set_temp).erase(id(graph_set_temp).begin());
            id(graph_rtd_temp).erase(id(graph_rtd_temp).begin());
            id(graph_probe1_temp).erase(id(graph_probe1_temp).begin());
            id(graph_probe2_temp).erase(id(graph_probe2_temp).begin());
          }
          // Update y_max based on mode, expand if any temp goes out of range
          float new_max = id(smoke_mode).state
            ? (id(use_celsius) ? 120.0f : 250.0f)
            : (id(use_celsius) ? 230.0f : 450.0f);
          for (float v : id(graph_set_temp)) if (v > new_max) new_max = v + 25.0f;
          for (float v : id(graph_rtd_temp)) if (v > new_max) new_max = v + 25.0f;
          for (float v : id(graph_probe1_temp)) if (!isnan(v) && v > new_max) new_max = v + 25.0f;
          for (float v : id(graph_probe2_temp)) if (!isnan(v) && v > new_max) new_max = v + 25.0f;
          id(graph_y_max) = new_max;

script:
  - id: sc_light_pot
    mode: single
    then:                      
    - logger.log: "1script.light_fire executing"
    - if:
        condition:
          #- binary_sensor.is_on: lighting_flag
          - switch.is_on: go
        then: # Light Pot
            - delay: 0.01s   #prevents race conditions from occuring
            - logger.log: "3SCRIPT.Lighting Pot now"
            - lambda: id(status_msg).publish_state("Lighting Fire Pot");              
            - switch.turn_on: hotrod_1_sw
            - switch.turn_on: auger_1_sw
            - delay: 90s # load up pellets

            #keep the pot going until lit
            - switch.turn_off: auger_1_sw
            
            - repeat:
                count: 3
                then:      
                  - logger.log:
                      format: "Keeping pot lit. Lighting Cycle counter = %d"
                      args: ['iteration + 1']
                  - delay: 30s
                  - switch.turn_on: auger_1_sw
                  - delay: 30s
                  - switch.turn_off: auger_1_sw
            #done keep the pot going until lit          
            #done lighting, set flags and status message
            - lambda: id(lighting_flag).publish_state(false);   
            - globals.set:
                id: lighting_flag_global
                value: 'false'             
            - lambda: id(status_msg).publish_state("Pot Lit");  
            - delay: 2s
            - lambda: id(status_msg).publish_state("Heating Mode");
            #pot should be lit by now
            # Get ready for heating/smoking
#            - switch.turn_on: smoke_mode
            - script.execute: sc_pot_heating
            - delay: 300s
            #keep hotrods on for 5 minutes
            - switch.turn_off: hotrod_1_sw

  - id: sc_pot_heating
    mode: restart
    then:
    - logger.log: "1script.sc_pot_heating.STARTING"   
    - while:
        condition:
            - switch.is_on: go
        then:      
          - logger.log: "1script.sc_pot_heating.ENTERING WHILE LOOP"    
          - script.execute: sc_pid_control        
          - logger.log: 
              format: "Heating cycle: ON time=%.1fs, OFF time=%.1fs"
              args: ["id(augers_heating_on_time).state", "id(augers_heating_off_time).state"]
          - switch.turn_on: auger_1_sw    
          - delay: !lambda "return id(augers_heating_on_time).state * 1000;"  
          - script.execute: sc_pid_control          
          - switch.turn_off: auger_1_sw            
          - delay: !lambda "return id(augers_heating_off_time).state * 1000;"  
          
  - id: sc_pot_smoking
    mode: restart
    then:
    - while:
        condition:
          - switch.is_on: go
        then:
          - logger.log: "BEGIN sc_pot_smoking"    
          - logger.log:
              format: "Smoke settings - On time: %.1fs, Off time: %.1fs"
              args: ['id(smoke_on_time).state', 'id(smoke_off_time).state']
          - switch.turn_on: auger_1_sw    
          - delay: !lambda "return id(smoke_on_time).state * 1000;"
          - switch.turn_off: auger_1_sw               
          - delay: !lambda "return id(smoke_off_time).state * 1000;" 
          - logger.log: "END of sc_pot_smoking script"
    #    
#
  - id: sc_stop_all_smoking
    mode: single
    then:
      - logger.log: "script Stop Everything"
      - lambda: id(status_msg).publish_state("Stopping...");
      # Stop all scripts
      - script.stop: sc_light_pot
      - script.stop: sc_pot_smoking
      - script.stop: sc_pot_heating
      # Turn off all switches
      - switch.turn_off: hotrod_1_sw
      - switch.turn_off: auger_1_sw
# 
  - id: sc_shutdown
    mode: single
    then:
      - while:
          condition:
            lambda: |-
              float temp = id(rtd_temperature_f).state;
              ESP_LOGD("Fan Control", "Checking temp %.1f against threshold 175.0", temp);
              return !isnan(temp) && temp > 175.0;
          then:
            - switch.turn_on: fans_on_off_sw
            - lambda: id(status_msg).publish_state("Cooling down - Fan ON");
            - delay: 120s
      - switch.turn_off: fans_on_off_sw
      - lambda: id(status_msg).publish_state("Fan OFF @ < 175F");
      - logger.log: "Smoker is now cool, turning off fans"

      # - while:
      #     condition:
      #       - lambda: return true;
      #     then:
      #       - if:
      #           condition:
      #             and:
      #                - switch.is_off: go
      #                - lambda: return id(a0_temperature).state < 100.0;
      #           then:
      #             - if:
      #                 condition:
      #                   switch.is_on: fans_on_off_sw
      #                 then:
      #                   - switch.turn_off: fans_on_off_sw
      #                   #- lambda: id(status_msg).publish_state("Cool down - Fans OFF");
      #           else:
      #             - if:
      #                 condition:
      #                   switch.is_off: fans_on_off_sw
      #                 then:
      #                   - switch.turn_on: fans_on_off_sw
      #                   #- lambda: id(status_msg).publish_state("Hot startup - Fans ON");
#
# GENERIC PID Controller
#
  # - id: sc_pid_control
  #   mode: single
  #   then:
  #     - logger.log: "sc_pid_control.STARTING"
  #     - lambda: |-
  #         // Configurable cycle parameters
  #         const float cycle_time = 15.0;          // Total cycle time in seconds
  #         const float min_multiplier = 0.033;     // Minimum fraction (e.g., 1s / 15s) 
  #         const float max_multiplier = 0.99;      // Maximum fraction (e.g., 13.5s)

  #         // Persistent variables
  #         static float integral = 0.0;
  #         static float last_error = 0.0;
  #         static unsigned long last_time = 0;

  #         // Get current time
  #         unsigned long current_time = millis();
  #         if (last_time == 0) {
  #             last_time = current_time;
  #             return;
  #         }       
  #         // Only update every 1s
  #         float dt = (current_time - last_time) / 1000.0;
  #         if (dt < 1.0) return;

  #         // Get sensor values
  #         float current_temp = id(rtd_temperature_f).state;
  #         float set_point = id(smoker_set_temp).state;
  #         float pb = id(pid_pb).state;
  #         float ti = id(pid_ti).state;
  #         float td = id(pid_td).state;

  #         // Validate inputs
  #         if (isnan(current_temp) || isnan(set_point) || pb <= 0 || ti <= 0 || td < 0) {
  #             ESP_LOGW("PID", "Invalid inputs - skipping update");
  #             return;
  #         }

  #         // Calculate error
  #         float error = set_point - current_temp;

  #         // Anti-windup - limit integral term
  #         float max_integral = 100.0; // Prevent excessive accumulation
  #         integral = std::max(-max_integral, std::min(max_integral, integral + error * dt));

  #         // Calculate PID gains
  #         float kp = 1.0;  // Base proportional gain
  #         float ki = 0.1;  // Base integral gain  
  #         float kd = 0.01; // Base derivative gain

  #         // Scale gains based on parameters
  #         kp *= (100.0 / pb);
  #         ki *= (kp / ti); 
  #         kd *= (kp * td);

  #         // PID Terms
  #         float p = kp * error;
  #         float i = ki * integral;
  #         float d = kd * (error - last_error) / dt;

  #         // Calculate output with improved scaling
  #         float output = (p + i + d) / 100.0; // Scale to 0-1 range
  #         output = std::max(0.0f, std::min(1.0f, output));

  #         // Calculate cycle times
  #         float on_time = output * cycle_time;
  #         float off_time = cycle_time - on_time;

  #         // Apply min/max constraints
  #         float min_time = cycle_time * min_multiplier;
  #         float max_time = cycle_time * max_multiplier;
  #         on_time = std::max(min_time, std::min(max_time, on_time));
  #         off_time = std::max(min_time, std::min(max_time, off_time));

  #         // Publish states
  #         id(pid_error).publish_state(error);
  #         id(augers_heating_on_time).publish_state(on_time);
  #         id(augers_heating_off_time).publish_state(off_time);

  #         // Debug logging
  #         ESP_LOGD("PID", "Error: %.2f, P: %.2f, I: %.2f, D: %.2f", error, p, i, d);
  #         ESP_LOGD("PID", "Output: %.2f, On: %.2f, Off: %.2f", output, on_time, off_time);

  #         // Update last values
  #         last_time = current_time;
  #         last_error = error;
  #         // Debug logging
  #         ESP_LOGD("PID", "P: %.3f, I: %.3f, D: %.3f", p, i, d);
  #         ESP_LOGD("PID", "IntSum: %.3f", integral);
  #         ESP_LOGD("PID", "Pb: %.3f, Ti: %.3f, Td: %.3f", pb, ti, td);
  #         ESP_LOGD("Temps", "SetTemp: %.3f, RTDTemp: %.3f, ErrorTemp: %.3f", set_point, current_temp, error);
          
  #     - logger.log: "sc_pid_control.ENDING"      
  #
# PID with Smith Predictor - not working, need to fix
#
  # - id: sc_pid_control
  #   mode: single
  #   then:
  #     - logger.log: "sc_pid_control.STARTING"
  #     - lambda: |-
  #         // Configurable cycle parameters
  #         const float cycle_time = 15.0;          // Total cycle time in seconds
  #         const float min_multiplier = 0.05;      // Minimum fraction of cycle_time (e.g., 0.03 * 15 = 0.45s)
  #         const float max_multiplier = 0.99;      // Maximum fraction of cycle_time (e.g., 0.99 * 15 = 14.85s)

  #         // Persistent variables
  #         static float last_temp = 0.0;           // Last temperature reading
  #         static unsigned long last_time = 0;     // Last timestamp in milliseconds
  #         static float integral = 0.0;            // Integral term for PID
  #         static float last_output = 0.0;         // Last PID output
  #         static float last_error = 0.0;          // Last predicted error for sign change detection

  #         // Get current time in milliseconds
  #         unsigned long current_time = millis();

  #         // Handle first run or invalid time (e.g., millis() overflow)
  #         if (last_time == 0) {
  #             last_time = current_time;           // Set initial time
  #             ESP_LOGD("PID", "Initializing: current_time = %lu", current_time);
  #             return;
  #         }

  #         // Calculate time delta in seconds
  #         float dt = (current_time - last_time) / 1000.0;  // Convert milliseconds to seconds
  #         if (dt < 0.001) {                        // Avoid very small or zero dt
  #             ESP_LOGD("PID", "dt too small: %f", dt);
  #             last_time = current_time;            // Update time even if skipping
  #             return;
  #         }

  #         // Get sensor values
  #         float current_temp = id(rtd_temperature_f).state;
  #         float set_point = id(smoker_set_temp).state;
  #         float pb = id(pid_pb).state;
  #         float error = set_point - current_temp;

  #         // Calculate PID gains (dynamic to handle changing parameters)
  #         float kp = (pb != 0.0) ? -1.0 / pb : 0.0;
  #         float ti = id(pid_ti).state;
  #         float ki = (ti != 0.0) ? kp / ti : 0.0;
  #         float kd = kp * id(pid_td).state;
  #         float tau = id(pid_tau).state;
  #         float theta = id(pid_theta).state;
  #         float center_factor = id(pid_center_factor).state;
  #         float stable_window = id(pid_stable_window).state;

  #         // Dynamic center
  #         float center = (set_point <= 240) ? (set_point * center_factor) : (set_point * center_factor * 1.2);

  #         // Smith Predictor
  #         float roc = (current_temp - last_temp) / dt;
  #         float predicted_temp = current_temp + (roc * theta) * (1 - exp(-dt / tau));
  #         float predicted_error = predicted_temp - set_point;

  #         // PID Terms
  #         float p = kp * predicted_error + center;
  #         integral += predicted_error * dt;
  #         integral = std::max(std::min(integral, 10000.0f), -10000.0f);  // Clamp integral sum
  #         float i = ki * integral;
  #         i = std::max(std::min(i, center), -center);  // Prevent windup
  #         float derivative = (predicted_temp - last_temp) / dt;
  #         float d = kd * derivative;

  #         // Calculate output
  #         float output = p + i + d;
  #         if (predicted_error < -pb) {
  #             output = 1.0;
  #         } else if (predicted_error > stable_window) {
  #             output = 0.0;
  #         }

  #         // Reset integral near setpoint, on saturation, or error sign change
  #         if (abs(error) <= 10 || output >= 1.0 || output <= 0.0 || (predicted_error * last_error < 0)) {
  #             integral = 0.0;
  #         }

  #         // Calculate on and off times
  #         float new_on_time = output * cycle_time;
  #         float new_off_time = (1.0 - output) * cycle_time;

  #         // Apply min and max constraints
  #         float min_time = cycle_time * min_multiplier;
  #         float max_time = cycle_time * max_multiplier;
  #         new_on_time = std::max(min_time, std::min(max_time, new_on_time));
  #         new_off_time = std::max(min_time, std::min(max_time, new_off_time));

  #         // Publish states
  #         id(pid_error).publish_state(error);
  #         id(augers_heating_on_time).publish_state(new_on_time);
  #         id(augers_heating_off_time).publish_state(new_off_time);

  #         // Update last values
  #         last_temp = current_temp;
  #         last_time = current_time;
  #         last_output = output;
  #         last_error = predicted_error;

  #         // Debug logging
  #         ESP_LOGD("PID", "CurrentTemp: %.3f, SetPoint: %.3f, Output: %.3f, OnTime: %.3f, OffTime: %.3f", 
  #                 current_temp, set_point, output, new_on_time, new_off_time);
  #         ESP_LOGD("PID", "P: %.3f, I: %.3f, D: %.3f, Center: %.3f", p, i, d, center);
  #         ESP_LOGD("PID", "PredErr: %.3f, IntSum: %.3f, Tau: %.3f, Theta: %.3f", 
  #                 predicted_error, integral, tau, theta);
  #         ESP_LOGD("PID", "Pb: %.3f, Ti: %.3f, Td: %.3f", pb, ti, id(pid_td).state);

  #New PIFIRE PID with Smith Predictor
  # PID Control Lambda for Smoker Temperature Control
  - id: sc_pid_control
    mode: single
    then:
      - logger.log: "sc_pid_control.STARTING"
      - lambda: |-
          // Configurable cycle parameters
          const float cycle_time = 15.0;          // Total cycle time in seconds
          const float min_multiplier = 0.02;      // Minimum fraction of cycle_time (0.3s)
          const float max_multiplier = 0.999;     // Maximum fraction of cycle_time (14.985s)

          // Persistent variables
          static float last_temp = 0.0;           // Last temperature reading
          static unsigned long last_time = 0;     // Last timestamp in milliseconds
          static float integral = 0.0;            // Integral term for PID
          static float last_output = 0.0;         // Last PID output
          static float last_error = 0.0;          // Last actual error for derivative
          static float kp = 0.0;                  // Proportional gain
          static float ki = 0.0;                  // Integral gain
          static float kd = 0.0;                  // Derivative gain
          static float set_point = 0.0;           // Current setpoint
          static unsigned long last_set_time = 0; // Time of last setpoint change
          static float start_change_temp = 0.0;   // Temp at last setpoint change
          static bool new_target = false;         // Flag for new setpoint

          // Get current time in milliseconds
          unsigned long current_time = millis();

          // Handle first run or invalid time
          if (last_time == 0) {
              last_time = current_time;
              ESP_LOGD("PID", "Initializing: current_time = %lu", current_time);
              return;
          }

          // Calculate time delta in seconds
          float dt = (current_time - last_time) / 1000.0;
          if (dt < 0.001) {
              ESP_LOGD("PID", "dt too small: %f", dt);
              last_time = current_time;
              return;
          }

          // Get sensor values
          float current_temp = id(rtd_temperature_f).state;
          float pb = id(pid_pb).state;  // Set to 50.0
          float ti = id(pid_ti).state;  // Set to 60.0
          float td = id(pid_td).state;  // Set to 5.0
          float tau = id(pid_tau).state;
          float theta = id(pid_theta).state;
          float center_factor = id(pid_center_factor).state;  // Set to 0.0
          float stable_window = id(pid_stable_window).state;  // Set to 10.0

          // Check for setpoint change
          float new_set_point = id(smoker_set_temp).state;
          if (new_set_point != set_point) {
              set_point = new_set_point;
              last_error = 0.0;
              integral = 0.0;
              last_time = current_time;
              last_set_time = current_time;
              start_change_temp = current_temp;
              new_target = true;
              ESP_LOGD("PID", "New setpoint: %.3f°F", set_point);
          }

          // Calculate gains
          if (pb != 0.0) {
              kp = 1.0 / pb;
          } else {
              kp = 0.0;
          }
          if (ti != 0.0) {
              ki = kp / ti;
          } else {
              ki = 0.0;
          }
          kd = kp * td;
          ESP_LOGD("PID", "kp: %.6f, ki: %.6f, kd: %.6f", kp, ki, kd);

          // Dynamic center
          float center = set_point * center_factor;

          // Smith Predictor
          float roc = (current_temp - last_temp) / dt;
          float predicted_temp = current_temp + (roc * theta) * (1 - exp(-dt / tau));
          float predicted_error = set_point - predicted_temp;
          float error = set_point - current_temp;

          // PID Terms
          float p = kp * predicted_error + center;
          integral += error * dt;
          integral = std::max(std::min(integral, 3000.0f), -3000.0f);
          float i = ki * integral;

          // Derivative
          float derv = (error - last_error) / dt;
          if (dt <= 0) derv = 0.0;
          float d = kd * derv;

          // Calculate output
          float u = p + i + d;

          // Soften output for extreme errors
          if (predicted_error < -150.0) {
              u = std::min(1.0f, u - 0.3f);
          } else if (predicted_error > 150.0) {
              u = std::max(0.0f, u + 0.3f);
          }

          // Reset logic
          if (new_target && abs(error) <= 5.0) {
              new_target = false;
          }
          if (new_target && current_time - last_set_time >= cycle_time * 3 && abs(error) <= abs(start_change_temp - set_point) / 2) {
              integral = 0.0;
          }
          if ((new_target && set_point < current_temp) || abs(error) > pb * 2) {
              derv = 0.0;
              d = 0.0;
          }
          // Soften output for small positive errors shortly after setpoint change
          if (error < pb / 2 && error > 0 && current_time - last_set_time < cycle_time * 3) {
              u *= 0.9;  // Less aggressive softening
          }

          // Anti-windup
          float u_clamped = std::max(0.05f, std::min(0.80f, u));
          if (ki != 0.0) {
              integral += (u_clamped - u) / ki;
              integral = std::max(std::min(integral, 3000.0f), -3000.0f);
          }
          u = u_clamped;

          // Reset for large integral
          if (abs(integral) > 3000) {
              integral = 0.0;
          }

          // Calculate on and off times
          float new_on_time = u * cycle_time;
          float new_off_time = (1.0 - u) * cycle_time;

          // Apply constraints
          float min_time = cycle_time * min_multiplier;
          float max_time = cycle_time * max_multiplier;
          new_on_time = std::max(min_time, std::min(max_time, new_on_time));
          new_off_time = std::max(min_time, std::min(max_time, new_off_time));

          // Publish states
          id(pid_error).publish_state(error);
          id(augers_heating_on_time).publish_state(new_on_time);
          id(augers_heating_off_time).publish_state(new_off_time);

          // Update last values
          last_temp = current_temp;
          last_time = current_time;
          last_output = u;
          last_error = error;

          // Debug logging
          ESP_LOGD("PID", "dt: %.3f", dt);
          ESP_LOGD("PID", "CurrentTemp: %.3f, SetPoint: %.3f, Output: %.3f, OnTime: %.3f, OffTime: %.3f", 
                  current_temp, set_point, u, new_on_time, new_off_time);
          ESP_LOGD("PID", "P: %.3f, I: %.3f, D: %.3f, Center: %.3f", p, i, d, center);
          ESP_LOGD("PID", "PredErr: %.3f, IntSum: %.3f, Tau: %.3f, Theta: %.3f", 
                  predicted_error, integral, tau, theta);
          ESP_LOGD("PID", "Pb: %.3f, Ti: %.3f, Td: %.3f", pb, ti, td);
          ESP_LOGD("PID", "StableWindow: %.3f", stable_window);
