Helno/pellet-grill-controller/(commit log)

2026-03-12 Rename project to pellet-grill-controller
    Remove broil-king.yaml and replace with pellet-grill-controller.yaml, updating internal name and friendly_name references.
    [pellet-grill-controller.yaml]
2026-03-12 Fix RTD temp alignment and remove trademark references
    - Align degree symbol under 'p' in RTD Temp label
    - Remove commented reference to Trager in touchscreen include
    [pellet-grill-controller.yaml]
2026-03-13 Fix fan shutdown loop
    Replace broken recursive sc_shutdown with while loop, remove conflicting
    fan control logic from fans_on_off_sw on_turn_off handler, and trigger
    sc_shutdown directly from system off instead of via fan switch.
    [pellet-grill-controller.yaml]
2026-03-13 Reduce SPI data rate to 20MHz for display reliability
    Lower ILI9488 SPI clock from 40MHz to 20MHz to fix intermittent
    display startup failure on cold power-on.
    [pellet-grill-controller.yaml]
2026-03-14 Add setup_priority to delay display initialization on boot
    Addresses intermittent display failure on startup by initializing
    the display later in the boot sequence, giving power rails time to stabilize.
    [pellet-grill-controller.yaml]
2026-03-15 Fix ADS1115 I2C address to 0x49
    ADDR pin is tied to VCC on the breakout board, setting address to 0x49.
    Also moved ADS1115 power from 5V VCC to 3.3V to match ESP32 I2C logic levels.
    [pellet-grill-controller.yaml]
2026-03-15 Add meat probe support, fix I2C/ADC wiring, improve display responsiveness
    - ADS1115: fix address to 0x49 (ADDR tied to VCC=3.3V), move to 3.3V rail
    - Probes: enable A0/A1 with 1kΩ pull-downs, disable A2/A3
    - PT1000 calibration: 2-point linear cal per probe from ice bath/boiling water
    - Display: increase SPI to 40MHz, reduce update_interval to 0.1s
    - Display: show P-select in smoke mode, set temp otherwise
    - Display: RTD temp and set temp colored to match graph lines
    - Display: show meat probe temps (single large or dual compact layout)
    - Graph: add green P1 and yellow P2 probe lines
    - Buttons: add pullup: true to all GPIO buttons, fix spurious smoke mode triggers
    - Buttons: reduce debounce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
    [pellet-grill-controller.yaml]
2026-03-15 Update KiCad schematic and PCB for hardware changes
    - ADS1115 VCC moved from 5V to 3.3V rail
    - Pull-down resistors R_A0/R_A1 changed from 150kΩ to 1kΩ
    [Traeger rev 2.3.0.kicad_pro.kicad_pcb, Traeger rev 2.3.0.kicad_pro.kicad_sch]
2026-03-15 Fix probe area black fill overwriting blue box border
    [pellet-grill-controller.yaml]
2026-03-18 Add GPIO16 backlight control to eliminate startup static
    Display LED pin connected to GPIO16 via jumper with 1k pull-down to GND.
    restore_mode: ALWAYS_OFF keeps backlight off during boot, on_boot turns
    it on after first display update for a clean startup image.
    [pellet-grill-controller.yaml]
2026-03-18 Scale graph to 150-250F in smoke mode, expand if out of range
    In smoke mode the graph Y axis uses a 150-250F range to show more
    detail at low temps. In normal mode it stays 150-450F. Both modes
    expand upward if any temp exceeds the top of the range.
    Gridlines adjusted: 175/200/225 in smoke, 200/300/400 in normal.
    [pellet-grill-controller.yaml]
2026-03-29 Improve WiFi reliability, display responsiveness, and button feedback
    - Add WPA3 SAE support to fix UniFi auth failures after firmware update
    - Replace fast_connect with power_save_mode: none for reliable AP scanning
    - Add fallback AP and captive portal for recovery when WiFi fails
    - Slow display refresh from 0.1s to 0.5s to reduce main loop blocking
    - Remove manual display updates from rotary encoder to prevent redraw queueing
    - Set temp button state directly before display update for instant visual feedback
    - Change default setpoint to 325°F, disable restore_value
    - Add C/F units toggle, hot start detection, PID integral tuning improvements
    - Reduce shutdown fan delay from 1200s to 120s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
    [pellet-grill-controller.yaml]
2026-03-29 Add Pit Boss P settings, meat probe setpoint, and smoke cycle display
    - Switch P settings from Traeger (P0-P5, 10s on) to Pit Boss (P0-P7, 18s on, 55-150s off)
    - Add meat probe setpoint (100-212°F, 5°F steps, default 165°F)
    - Rotary knob click cycles between temp/P-select and probe setpoint (only when probe connected)
    - Physical buttons and rotary encoder all support probe setpoint adjustment
    - Smoke mode display shows P level with on/off times, active phase flashes
    - Probe temperature flashes when it reaches or exceeds the setpoint
    - Dashed green line on graph shows probe setpoint when probe connected
    - Default grill setpoint changed to 325°F with restore_value disabled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
    [pellet-grill-controller.yaml]
