Helno/pellet-grill-controller/(notices)

Notices in the files:
Traeger rev 2.3.0.kicad_pro.kicad_pcb:
(c)2025,2026 Jeff Stevenson
